mwhite494/Beta-Air/Datasheets/LoadCell.jpg

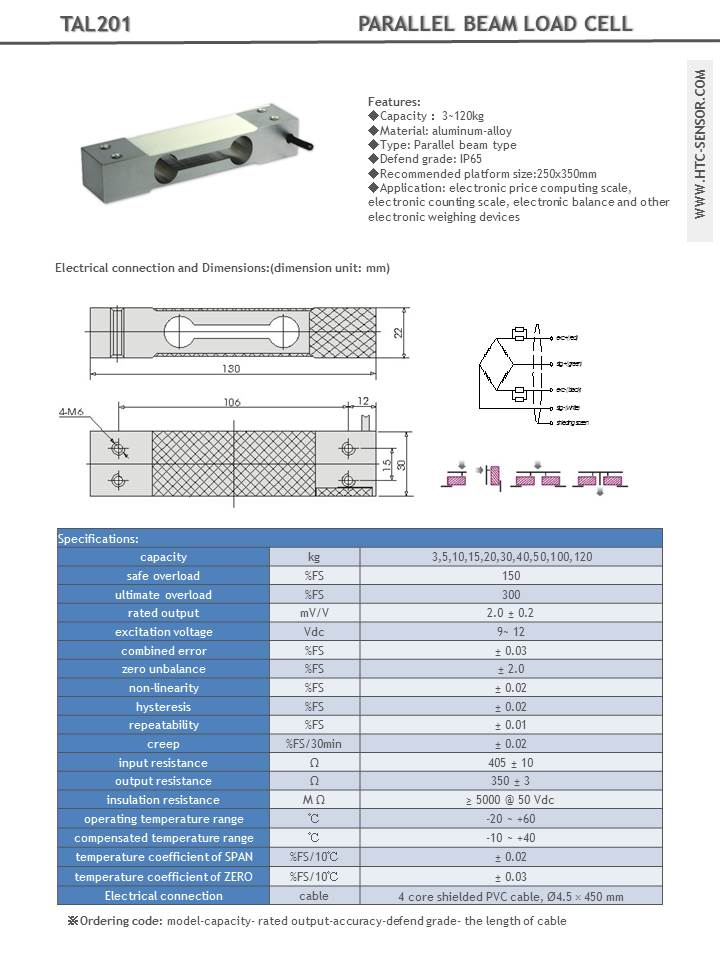
Datasheets/LoadCell.jpg
