mwhite494/Beta-Air/README.md

# Beta Air

2016 UVM SEED Team #14: Redesigning the Pilot Interface

This repository contains the Arduino programs and other relevant files associated with the 2016 UVM SEED Team #14 engineering design project.

Photos and videos of the project:

Project Video: https://www.youtube.com/watch?v=wAZS4JNMeh0

Project Photo Album: https://www.flickr.com/gp/142660890@N02/3o64sP

RC Controller Hack Test: https://www.youtube.com/watch?v=XJeJI30qO8o

First Quadcopter Flight: https://www.youtube.com/watch?v=InLttBTRIWE

Pilot Interface Test: https://www.youtube.com/watch?v=YcpARFiyPvk

FPV Test: https://www.youtube.com/watch?v=XzfPLiM6aTw

Project Demo Flight: https://www.youtube.com/watch?v=uJsYDV2VDIQ

Project Demo GoPro Footage: https://www.youtube.com/watch?v=i7uWAD_RpNU

Flight Test GoPro Footage Part 1: https://www.youtube.com/watch?v=Y2U4ofDHF3M

Flight Test GoPro Footage Part 2 (with near crash): https://www.youtube.com/watch?v=P7VsnGtim4Y
