mwhite494/Beta-Air/Bill-of-Materials/README.md

This is the current bill of materials for the prototype.
