mwhite494/Beta-Air/Bill-of-Materials/bill of materials.xlsx

Item | Description |  | Cost
Motorcycle platform
Iron thread fitting round head cap | Cap and collar for central support | 1 | $43.81 | McMaster-Carr
3.906" OD .393" wire diameter spring | Springs for central support | 2 | $52.26 | McMaster-Carr
Steel-wall pipe 4" OD, threaded on one end | Central support | 36" | $134.64 | McMaster-Carr
Subaru Outback Driveshaft | U-joint for central support | 1 | $75 | Rathe's Salvage Yard
1988 Suzuki Katana Frame | Rolling motorcycle chassis | 1 | $300 | Craigslist
1 in by 1 in Cube Steel | Material for motorcycle stand | 9 ft | $36 | Aubuchon Hardware
1/4" thick stainless steel plate | Material for motion platform and frame modification | 4x18" | $75 | McMaster-Carr
3/8" thick stainless steel plate | material for motor arms | 4x6" | 31.64 | McMaster-Carr
3/4x16" hex nuts | interface between Heim joints and Motors | 10 | $12 | McMaster-Carr
3/4" steel rod | U-joint for central support | 1 | $75 | Rathe's Salvage Yard
10 kohm analog potentiometers | Potentiometers for throttle assembly | 1 | $0.95 | Sparkfun
75 kohm precision potentiometers | Potentiometer for measuring handlebar rotation | 1 | $10 | Marco
3D Printed ABS Plastic | Custom parts for potentiometer assemblies | ~5 cubic in | $5 | UVM FabLab
9V Batteries | Batteries for Arduinos | 2 | $10 | Marco
Breadboard | For testing pilot interface circuit | 1 | $1 | Marco
Arduino Uno | Microcontroller platform | 3 | $20 | Marco, Jake, Casey
Force Sensitive Resistors (FSR) | Pressure sensors at rider's knees | 2 | $15.90 | Sparkfun
MCP6004 | Op-amps for FSRs | 1 | $0.48 | Mouser
SRS-0505 | 5V-5V DC-DC converter to drive FSRs | 1 | $7.34 | Mouser
10 kg Load Cell (TAL201) | For measuring pitch input on the handlebars | 1 | $11.95 | Sparkfun
HX711 Load Cell Amplifier | Amplifier board for the load cell | 1 | $9.95 | Sparkfun
MCP4251 | 10 kohm digital potentiometers | 2 | $2.04 | Mouser
4.7 kohm Resistors |  | 2 | 0.10$ | Marco
750 ohm Resistors |  | 2 | $0.05 | Marco
680 ohm Resistors |  | 1 | $0.05 | Marco
33 ohm Resistors |  | 2 | $0.05 | Marco
14.8V Lipo Batteries | Batteries for the quadcopter | 2 | $66.45 | Friend of Jake
7.4V Lipo Battery | Battery for the FPV transmitter | 1 | $25 | Jake
Lipo Battery Charger |  | 1 | $20 | Jake
Lipo Safe Charging Bag |  | 1 | $3 | Jake
FPV Transmitter / Reciever |  | 1 | $75 | Helipal
12 V Power Supply | Power supply for FPV reciever | 1 | $15 | Kyle
GoPro Hero 3+ | FPV Camera | 1 | $300 | Marco
Modified GoPro Case |  | 1 | - | Marco
RCA Adapter Plug | To connect RC reciever to TV | 1 | $4 | Helipal
TV |  | 1 | $200 | Austin
NAZA Lite Flight Controller | Flight controller for the quadcopter | 1 | $180 | Helipal
Spektrum RC Reciever | Reciever connected to the flight controller | 1 | $15 | Jake
Spektrum DX6i Controller | Master and slave controllers | 2 | $260 | Jake
Trainer cable | Cable to connected master and slave controllers | 1 | $8 | Jake
 |  | Total: | $2,094
