mwhite494/Beta-Air/Printed-Circuit-Board/Pilot_Interface_005.brd

## EAGLE design Printed-Circuit-Board/Pilot_Interface_005.brd (2016-05-14)

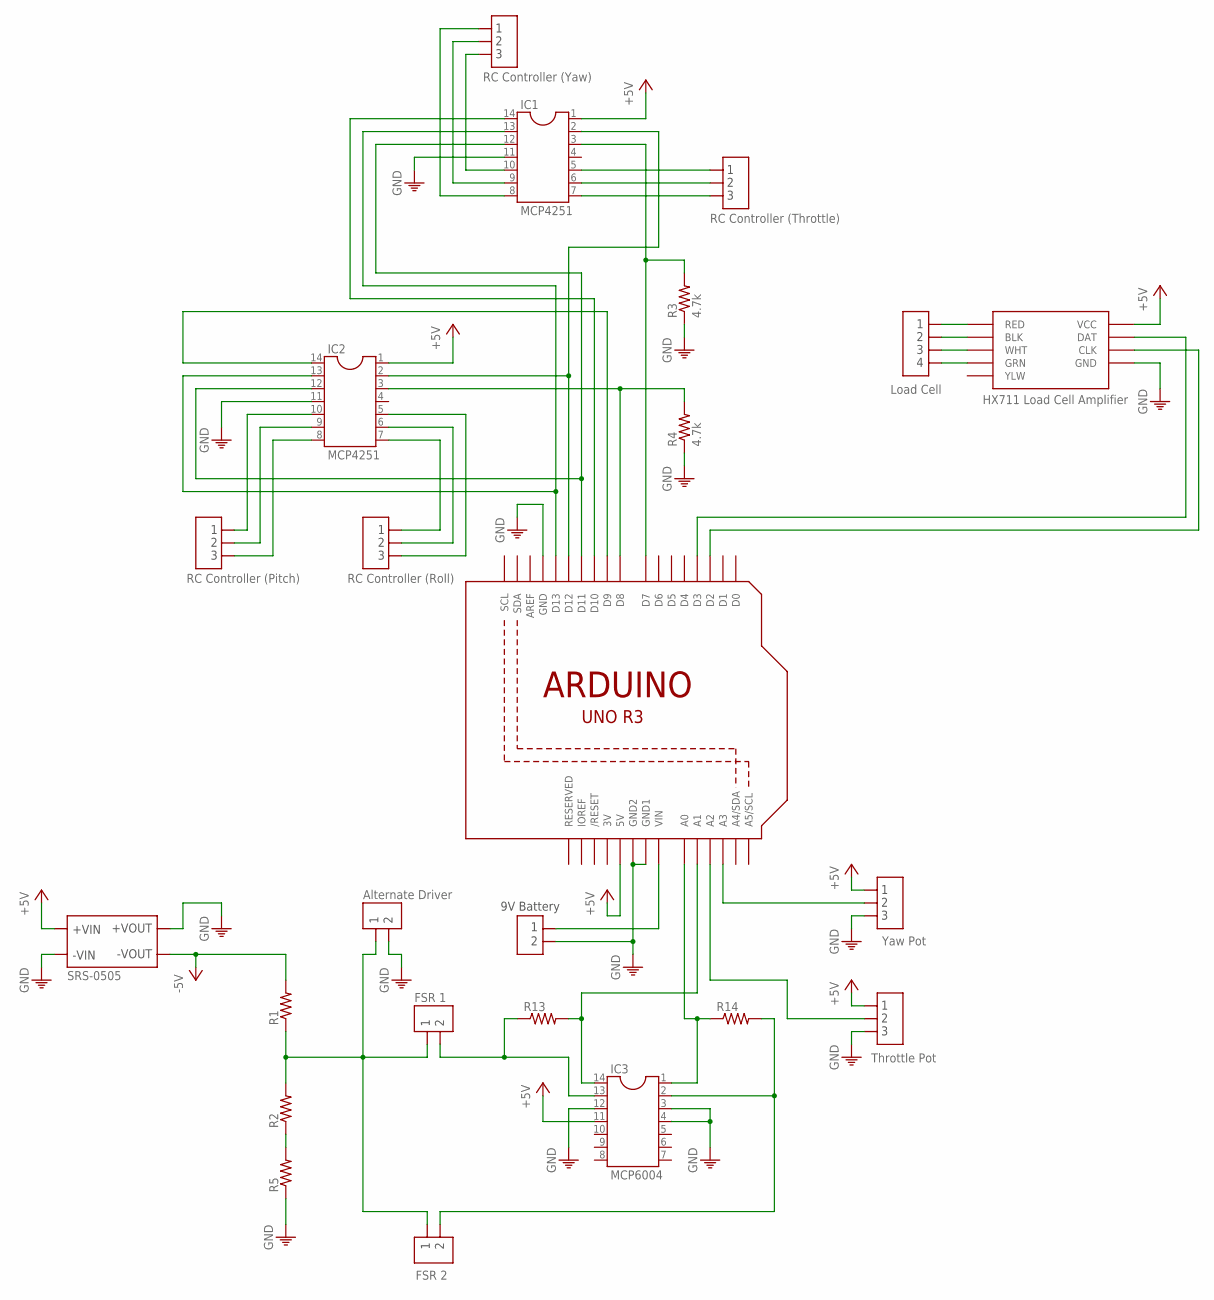
[picture p2: schematic Pilot_Interface_005.sch]

Parts:
IC1, IC2: MCP4251; DIL14
IC3: MCP6004; DIL14
R1, R2, R5, R13, R14: R-US_0204/2V; 0204V
R3, R4: 4.7k; 0204V
U1: ARDUINOR3
U$1: HX711
U$2, U$3, U$6, U$7, U$10, U$11: PAD_3
U$4, U$5, U$12, U$13: PAD_2
U$8: PAD_4
U$9: SRS-0505

Connections:
3V: U1.3V
+5V: IC1.1 (14), IC2.1 (14), IC3.11 (4), U1.5V, U$1.VCC, U$6.P$1, U$7.P$1, U$9.P$1 (+VIN), U$9.P$16 (+VIN)
-5V: R1.2, U$9.P$6 (-VOUT), U$9.P$11 (-VOUT)
unnamed: U$1.RED, U$8.P$1
unnamed: U$1.BLK, U$8.P$2
unnamed: U$1.WHT, U$8.P$3
unnamed: U$1.GRN, U$8.P$4
unnamed: IC3.2 (13), R14.2, U$5.P$2
unnamed: U1.D2, U$1.CLK
unnamed: U1.D3, U$1.DAT
unnamed: IC3.14 (1), R13.2, U1.A1
unnamed: IC3.1 (14), R14.1, U1.A0
unnamed: U1.A3, U$6.P$2
unnamed: U1.A2, U$7.P$2
unnamed: R1.1, R2.2, U$4.P$1, U$5.P$1, U$12.P$1
unnamed: IC2.14 (1), U1.D9
unnamed: IC1.14 (1), U1.D10
unnamed: IC1.13 (2), IC2.13 (2), U1.D13
unnamed: IC1.12 (3), IC2.12 (3), U1.D11
unnamed: IC1.2 (13), IC2.2 (13), U1.D12
unnamed: IC1.3 (12), R3.2, U1.D7
unnamed: IC2.3 (12), R4.2, U1.D8
unnamed: IC1.5 (10), U$3.P$1
unnamed: IC1.6 (9), U$3.P$2
unnamed: IC1.7 (8), U$3.P$3
unnamed: IC1.10 (5), U$2.P$3
unnamed: IC1.9 (6), U$2.P$2
unnamed: IC1.8 (7), U$2.P$1
unnamed: IC2.8 (7), U$10.P$3
unnamed: IC2.9 (6), U$10.P$2
unnamed: IC2.10 (5), U$10.P$1
unnamed: IC2.7 (8), U$11.P$1
unnamed: IC2.6 (9), U$11.P$2
unnamed: IC2.5 (10), U$11.P$3
unnamed: IC3.13 (2), R13.1, U$4.P$2
unnamed: R2.1, R5.2
unnamed: U1.VIN, U$13.P$1
PE: IC1.11 (4), IC2.11 (4), IC3.3 (12), IC3.4 (11), IC3.12 (3), R3.1, R4.1, R5.1, U1.GND, U1.GND1, U1.GND2, U$1.GND, U$6.P$3, U$7.P$3, U$9.P$7 (+VOUT), U$9.P$8 (-VIN), U$9.P$9 (-VIN), U$9.P$10 (+VOUT), U$12.P$2, U$13.P$2

Notes on the sheet:
FSR 1
FSR 2
Throttle Pot
Yaw Pot
Load Cell
RC Controller (Yaw)
RC Controller (Throttle)
RC Controller (Pitch)
RC Controller (Roll)
Alternate Driver
9V Battery

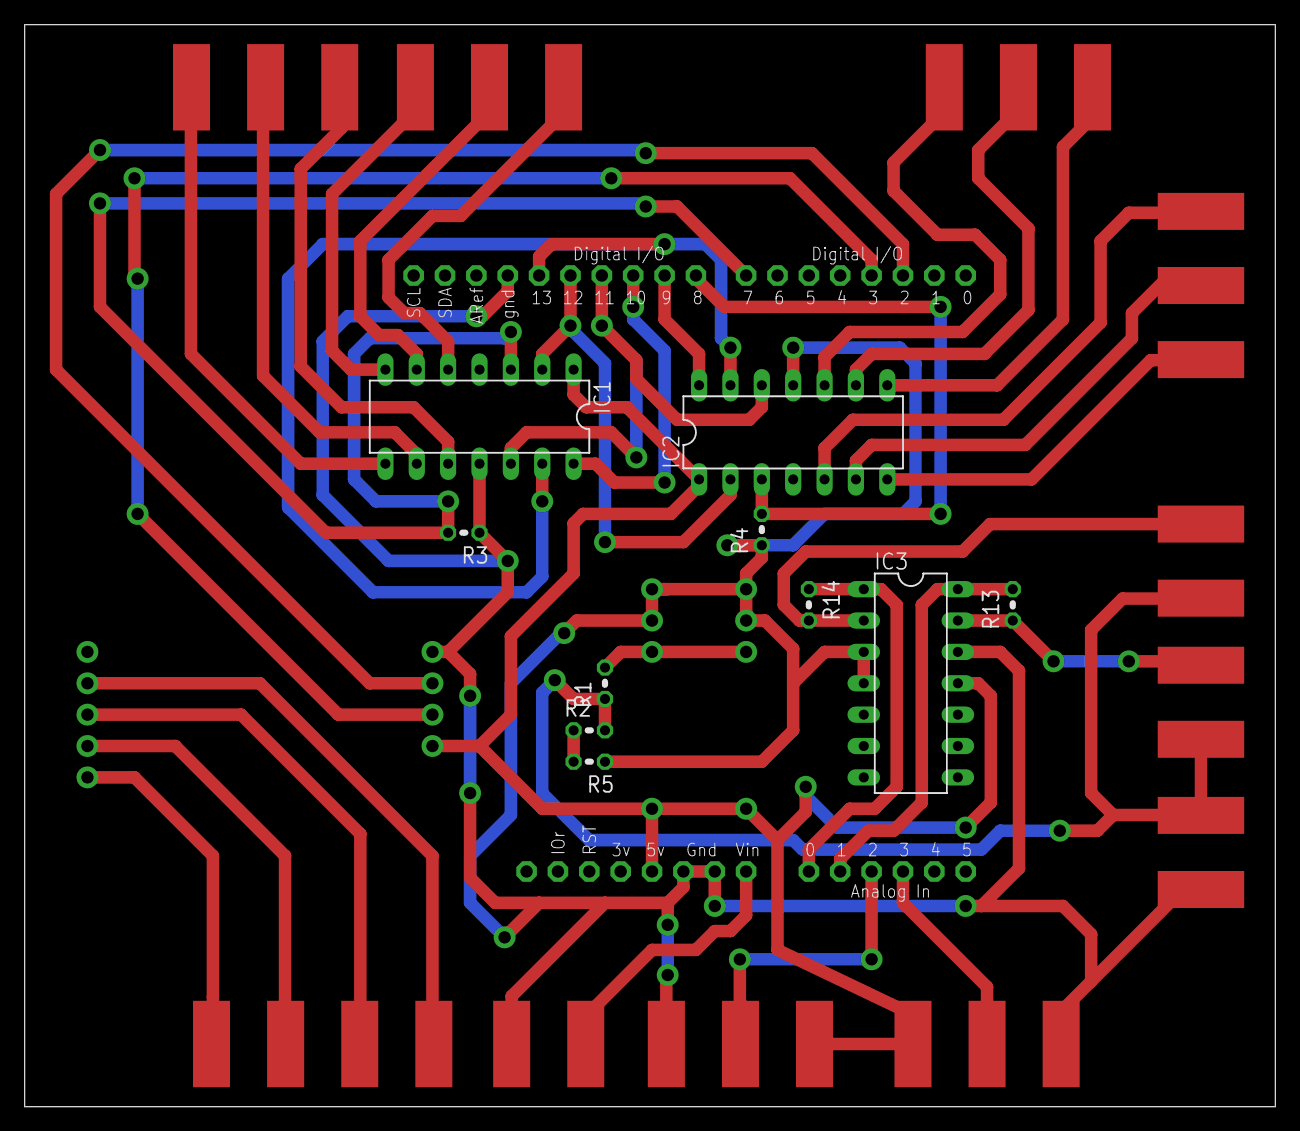
[picture p3: board Pilot_Interface_005.brd from above]

Board: 2 copper layers, 101.3 x 87.6 mm, 24 parts (0 on the bottom side), 37 nets.
