mwhite494/Beta-Air/Printed-Circuit-Board/board.png

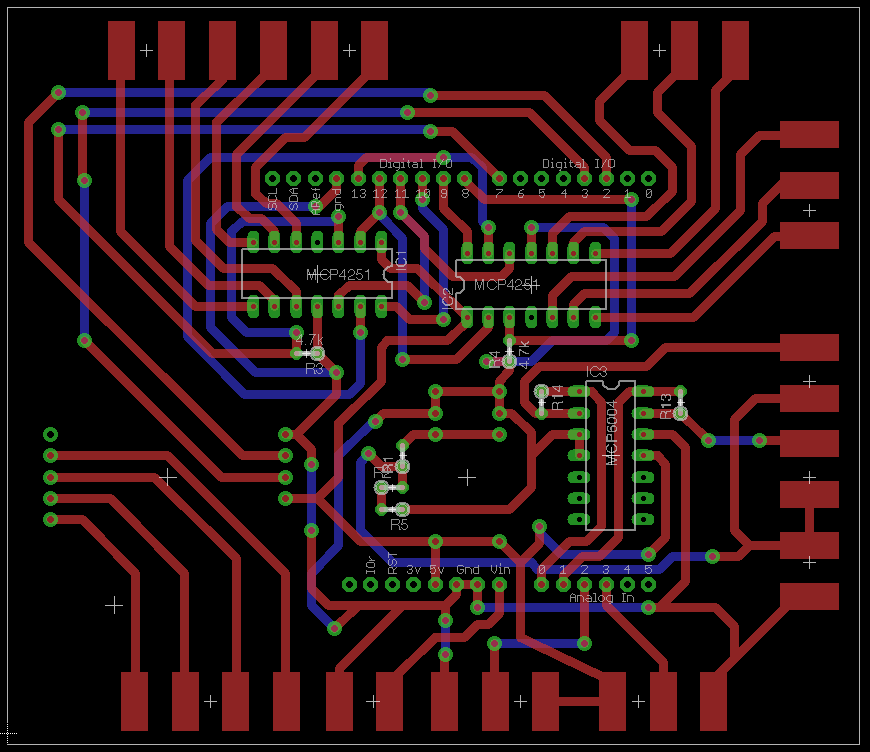
Printed-Circuit-Board/board.png
