mwhite494/Beta-Air/Printed-Circuit-Board/PIS.png

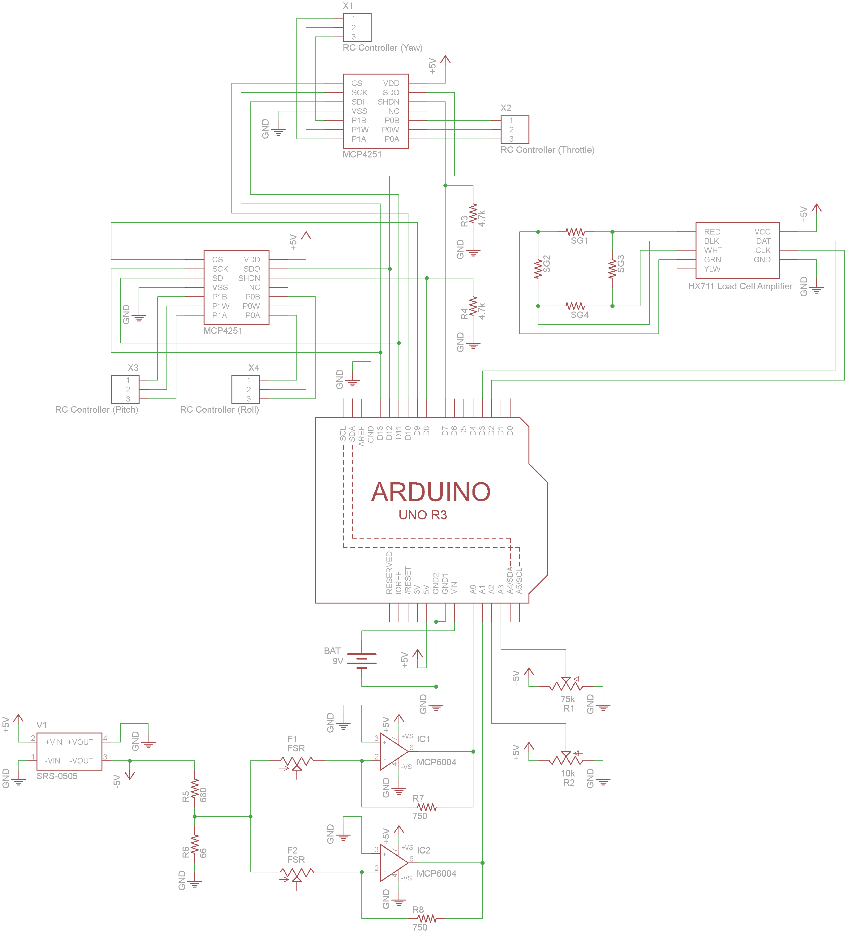
Printed-Circuit-Board/PIS.png
